pr0grara/EVERFRESH/pamphlet-assets/room.jpg

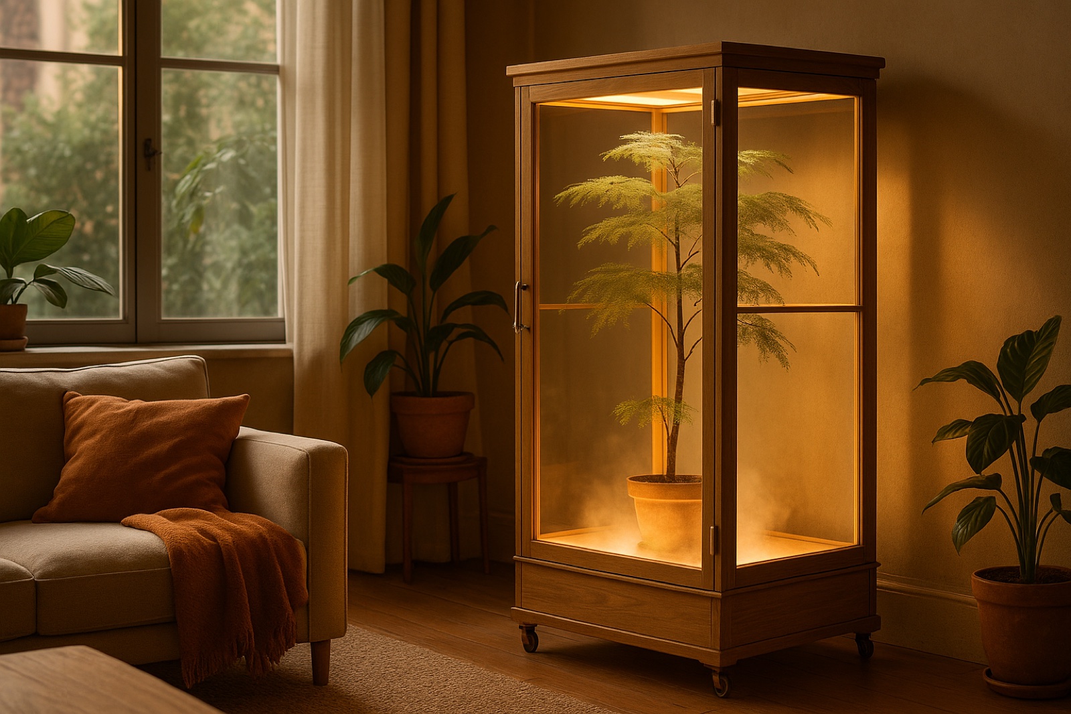
pamphlet-assets/room.jpg
