pr0grara/EVERFRESH/pamphlet-assets/pg1.png

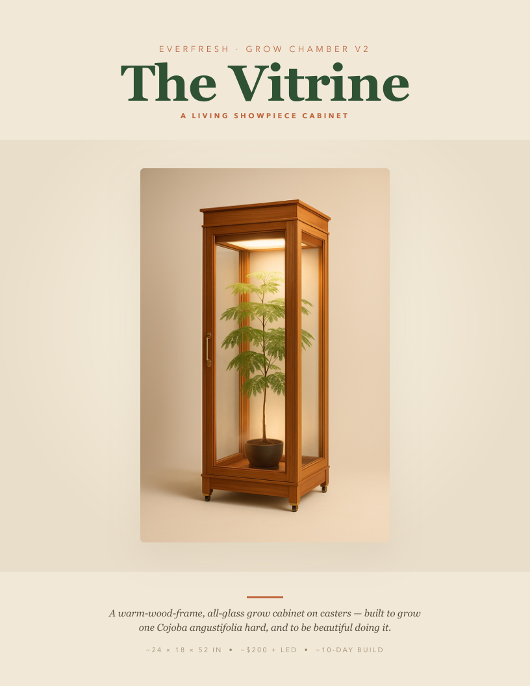
pamphlet-assets/pg1.png
