pr0grara/EVERFRESH/pamphlet-assets/existpdf.png

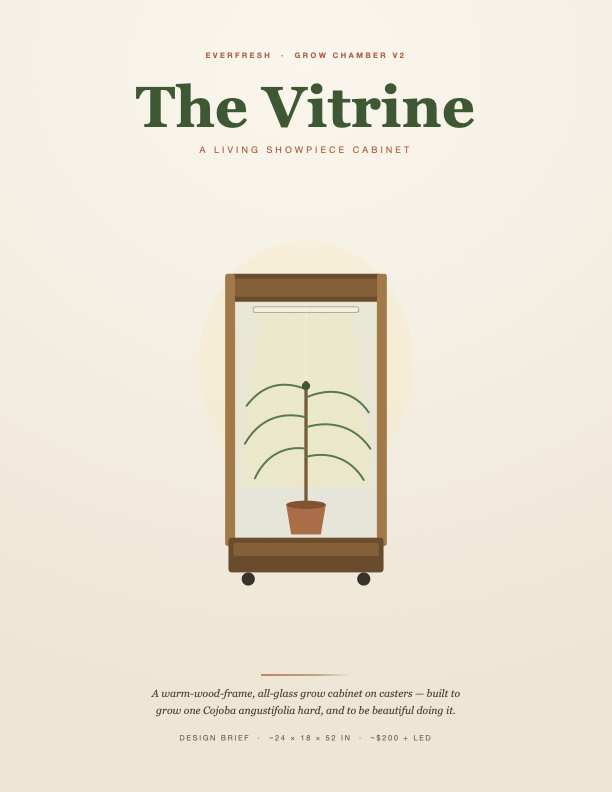
pamphlet-assets/existpdf.png
