pr0grara/EVERFRESH/pamphlet-assets/pg2.png

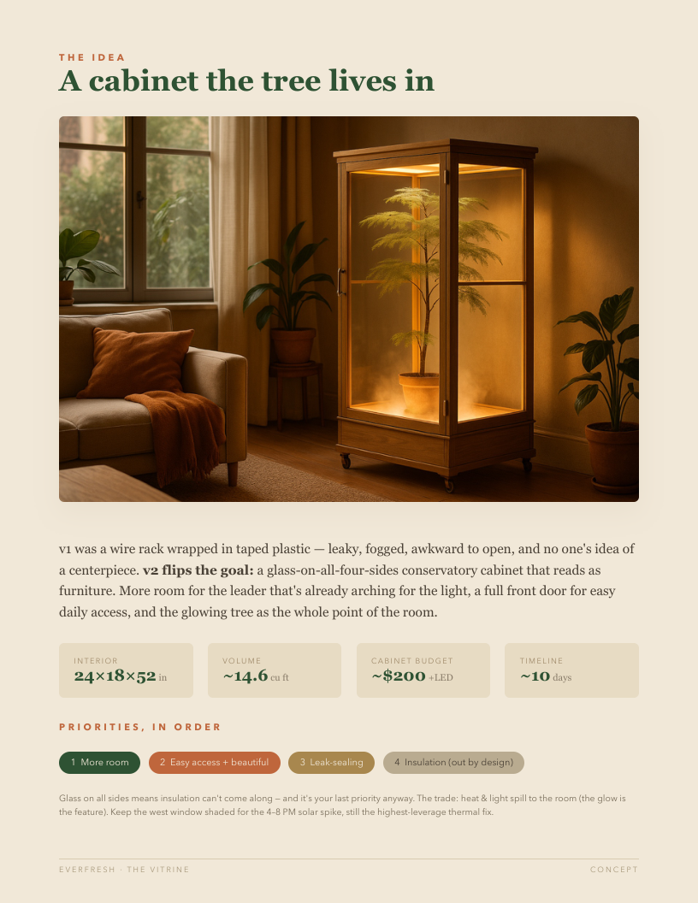
pamphlet-assets/pg2.png
