pr0grara/EVERFRESH/pamphlet-assets/pg3.png

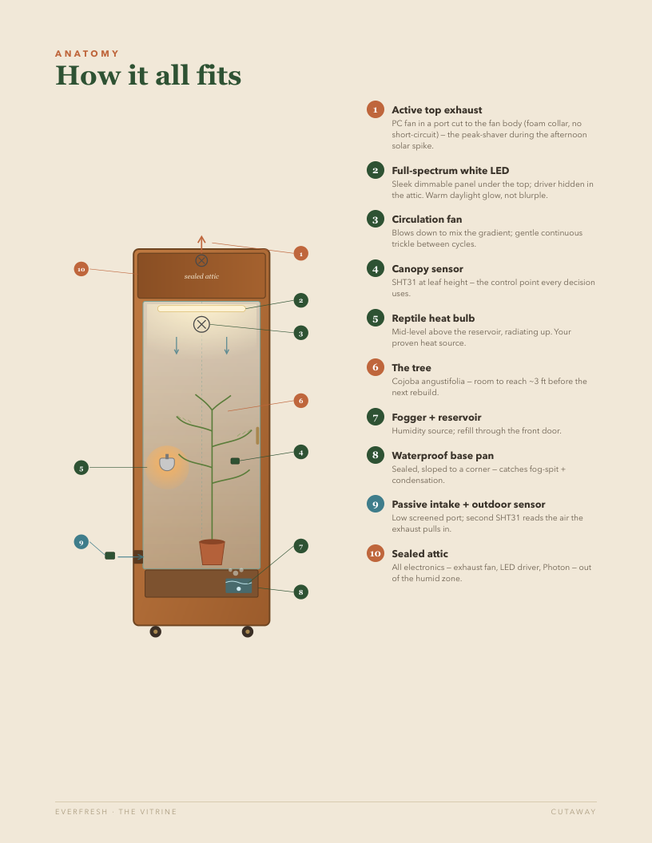
pamphlet-assets/pg3.png
