pr0grara/EVERFRESH/pamphlet-assets/pg4.png

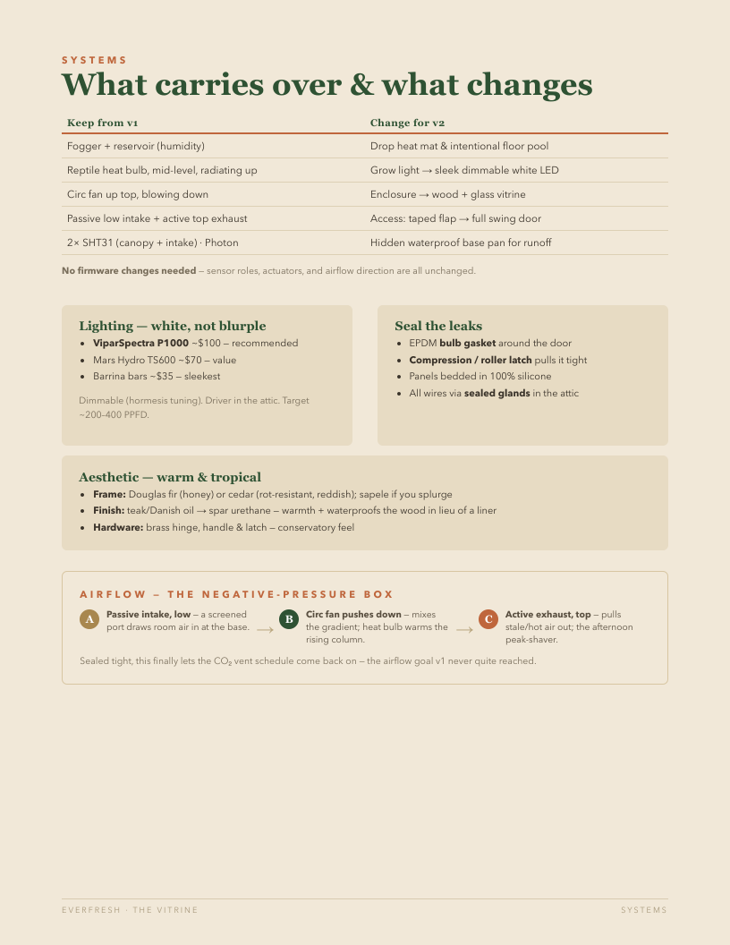
pamphlet-assets/pg4.png
