pr0grara/EVERFRESH/pamphlet-assets/pg5.png

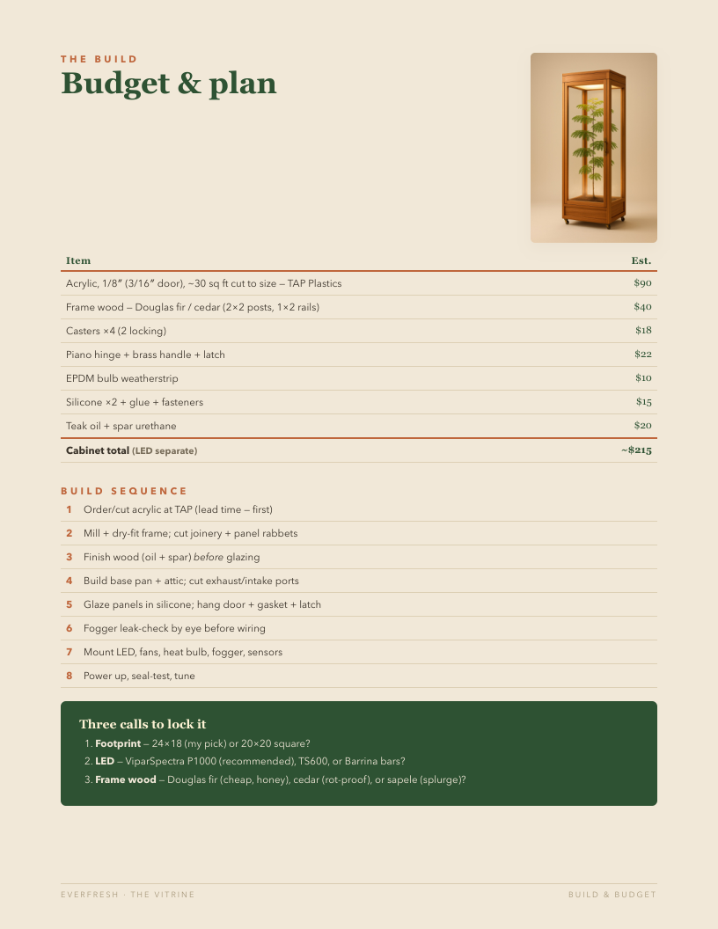
pamphlet-assets/pg5.png
