pr0grara/EVERFRESH/CHANGELOG.md

# EVERFRESH — Changelog

Firmware (`everfresh.ino`) version history, newest first. Each entry: version — date — very brief summary. Versioning is loose semver: `1.MINOR.PATCH`, minor for a new control paradigm/behavior, patch for a tune/fix.

> Renumbered 2026-07-09 so each minor line tracks a control paradigm: `1.1.x` = the VPD-control era, `1.2.x` = the ceramic-heater era. Git commit subjects predating this use the older flat `1.0.x` numbers.

## v1.2.18 — 2026-10-09
Control survives a Wi-Fi/cloud outage. On 10/8 the modem died and the Photon was dark 26.6h. Without `SYSTEM_THREAD(ENABLED)` the app shared the system thread: losing the cloud blocked `loop()`, the 60s `ApplicationWatchdog` reset the device, and after each reset `setup()` waited for the cloud, so every actuator pin floated off for the whole outage (reconnected at 165s uptime, canopy at 59% RH).

- **`SYSTEM_THREAD(ENABLED)`:** setup and the control loop run from boot regardless of Wi-Fi. Before the clock syncs, the existing afternoon-phase fallback applies.
- **`cloudPub()` wrapper** replaces every `Particle.publish`: skips when `!Particle.connected()` so an offline publish can't stall the app thread.
- **Edge alerts retry:** `publishAlerts()` latches a circ-stall / overheat / no-sensor / cleared edge only after the publish succeeds, so an alert raised offline lands when the cloud returns.
- **Off-device companion:** the arabuilds scheduler job "everfresh watchdog" (every 5 min) texts when telemetry goes stale for 20 min, and again when it resumes.

## v1.2.17 — 2026-09-13
Persistent-alert bidaily nag. The edge-triggered alerts in `publishAlerts()` (circ-stall / overheat / no-sensor) fired exactly once on transition, so a fault that didn't self-heal went silent after its first text. Now, matching the v1.2.16 reservoir-dry cadence, `publishAlerts()` re-publishes the still-active alert every `ALERT_REALERT_MS` (12h) while the same condition holds. Requested for circ-stall specifically; generalized to all three since none self-heal and re-nagging a sustained overheat/no-sensor is strictly safer. `"cleared"` still fires once on recovery (no nag). New static `lastAlertPub` timer; reset on every edge so a changed alert re-arms the clock.

## v1.2.16 — 2026-09-13
Reservoir dry-out watchdog + bidaily SMS nag. On 9/12 the fogger reservoir ran dry ~8:47PM; the sheet log showed the signature cleanly — fog pinned 100% ON continuously while canopy RH decoupled and slid 75→57%, then sat at ~55-58% for ~14h with fog at full duty (transducer firing into empty water, atomizing nothing). No alert fired at the time; this adds one.

- **New `publishReservoirAlert()` detector** → publishes `everfresh/alert` = `"reservoir-dry"` when fog is commanded ON continuously for `RES_DRY_MS` (20 min) while canopy RH stays below `RES_DRY_RH` (= `RH_FOG_ON`, 65%). A watered chamber recovers RH within minutes and cycles fog off, so a 20-min flat-out run with no RH response is the dry tell. Clears (`"reservoir-refilled"`) when RH recovers above `RES_OK_RH` (72%) — sits cleanly between the ~55-58% dry floor and the 74-80% normal band so it won't false-clear or nag forever.
- **Bidaily nag:** unlike the edge-triggered alerts, this re-publishes `reservoir-dry` every `RES_REALERT_MS` (12h) while still dry — a refill reminder, since a dry reservoir doesn't self-heal. Deliberately independent of `publishAlerts()`'s single-slot priority system so it can coexist with a simultaneous circ-stall/overheat and keep its own cadence. No-sensor holds the latch (can't judge RH response blind; the no-sensor alert covers that).
- **Off-device:** reuses the v1.2.14 path — Particle webhook → arabuilds `/api/everfresh-alert` → Twilio SMS. Added `reservoir-dry` / `reservoir-refilled` message bodies there.

## v1.2.15 — 2026-09-08
Baseline circ-mix bump. Raised `CIRC_MIX_DUTY` 1%→10% for stronger continuous chamber mixing between fog cycles. Note this floor also drives the mode-3 night dry-excursion pin (circ held at `CIRC_MIX_DUTY` when `excDrying`), so night idle mixing rises to 10% too; `CIRC_NIGHT_MIN` (1) and `HEAT_CIRC_MIN` (1) are separate constants and unchanged. Watch the floor pool for over-drying at the higher baseline.

## v1.2.14 — 2026-08-20
Circ-fan mixing-failure watchdog + SMS alert. The circ fan died 8/20 (inertial bearing lock, freed by hand). Post-mortem on the sheet log showed it had been dying for ~2 weeks — clean ΔT baseline (canopy−ambient ~4-5°F) held until ~8/05, then intermittent stalls spiking ΔT to 24-31°F, lengthening each time (minutes → 40 → 89 → locked). The tell is ΔT, not fog/vent runtime: a real solar spike keeps ΔT low (canopy+ambient rise together), but a stalled fan lets the canopy pocket bake, and stalls hit at all hours incl. dark ones (mechanical, not solar).

- **New `circMixingStalled()` detector** → publishes `everfresh/alert` = `"circ-stall"` when `(canopy − ambient) ≥ CIRC_STALL_ON_DELTA_F` (12°F) holds for `CIRC_STALL_MS` (10 min); clears below `CIRC_STALL_OFF_DELTA_F` (9°F). Hysteretic + time-latched so solar-edge transients can't trip it. Needs both sensors (ambient down → can't judge mixing; no-sensor alert covers canopy loss).
- Folded into `publishAlerts()` priority after no-sensor/overheat (edge-triggered — only publishes on transition).
- **Off-device:** a Particle webhook forwards `everfresh/alert` → arabuilds `/api/everfresh-alert` → Twilio SMS to Ara's cell (from the arabuilds line +14159032724) on any real alert, "cleared" on recovery. Would have paged ~8/07, two weeks before failure.

## v1.2.13 — 2026-08-04
Recovery-week VPD softening. Proactive (not a stress signal): a fresh coppery terminal flush landed the same week as a transplant into a larger pot (2 trip / 1 orchid / 1 potting). Tender new tissue + disturbed roots = lower water supply against higher demand, so ease evaporative pull for ~1 week while the flush hardens and roots re-knit.

- **Ceilings down ~0.15 uniformly** (floors 0.55/0.70/0.85 untouched, so no extra daytime venting; fog just comes on sooner): night/morning `_HI` 1.05→0.90, afternoon 1.15→1.00, evening `_HI` 1.15→1.00, spike `VPD_EVE_CAP` 1.40→1.25.
- Ladder still non-decreasing (night 0.90 = morning 0.90 < afternoon 1.00 = eve HI 1.00 < cap 1.25).
- **Temporary** — re-raise toward the 7/26 ladder once the copper greens up and roots establish.

## v1.2.12 — 2026-07-28
Night vent noise cap. Full-duty venting (cooling pulse / RH relief / dry swing / scheduled exchange) was a 100% blast — too loud at night.

- **Night only:** those reasons now soft-start at `NIGHT_VENT_START_PCT` 10% and ramp to a `NIGHT_VENT_MAX_PCT` 50% ceiling over `NIGHT_VENT_RAMP_MS` (5 min), so brief blips stay ~quiet and only a sustained need climbs to the cap.
- **Untouched:** near-silent moisture-export vent (~1%), the `VENT_EMERGENCY_F` runaway backstop (still forces 100%), and all daytime venting.

## v1.2.11 — 2026-07-26
Further gentle de-stress: another small ceiling down-tick after the 7/23 walk-back proved insufficient.

- **Night/Morning** `VPD_NIGHT_HI`/`VPD_MORN_HI` 1.10→1.05.
- **Afternoon** `VPD_AFT_HI` 1.20→1.15.
- **Evening** `VPD_EVE_HI` 1.20→1.15 and spike cap `VPD_EVE_CAP` 1.45→1.40.
- Floors still untouched (0.55/0.70/0.85) — wet side unchanged; this only makes fog trigger sooner. Ladder still non-decreasing (night 1.05 = morning 1.05 < afternoon 1.15 = evening HI 1.15 < cap 1.40).
- **Trigger:** discoloration now appearing on some leaf **tips** (dry-air tip burn) — the 7/23 half-step wasn't enough to keep the ceramic heater's drying off the canopy. Same monitor-and-adjust discipline; re-read the tips before moving again.

## v1.2.10 — 2026-07-23
Gentle de-stress: partial walk-back of the 7/15b ladder raise after drying pinnae reappeared.

- **Morning** `VPD_MORN_HI` 1.20→1.10 (band 0.55–1.10).
- **Afternoon** `VPD_AFT_HI` 1.30→1.20 (band 0.70–1.20).
- **Evening** `VPD_EVE_HI` 1.30→1.20 and spike cap `VPD_EVE_CAP` 1.50→1.45.
- Floors untouched (0.55/0.70/0.85) — wet side and daytime venting unchanged; this only makes fog trigger sooner. Ladder still non-decreasing (night 1.10 = morning 1.10 < afternoon 1.20 < evening cap 1.45) and morning is back under the old afternoon.
- **Trigger:** ~10 drying pinnae on the leaf nearest the ceramic element + ~5 scattered plant-wide — the same signature as the 7/09 episode that the 7/15a/b raises walked back. Deliberately ~half-way back, not a full revert: this is a monitor-and-adjust step, not an abandonment of the hormetic ladder. See OBSERVATIONS.md 2026-07-23, including a suspected leaf-on-sensor fault that could be biasing canopy RH high (and therefore VPD low) independent of any setpoint.

## v1.2.9 — 2026-07-15
Raise the whole hormetic VPD ladder — strictly ascending fog-triggers through the day.

- **Morning** `VPD_MORN_HI` 0.95→1.20 (band 0.55–1.20).
- **Afternoon** `VPD_AFT_HI` 1.15→1.30 (band 0.70–1.30).
- **Evening** `VPD_EVE_HI` 1.15→1.30 and spike cap `VPD_EVE_CAP` 1.40→1.50 (band 0.85–1.30, solar-window ceiling 1.50).
- Ceiling ladder now night 1.10 < morning 1.20 < afternoon 1.30 < evening 1.50. Floors kept (0.55/0.70/0.85 — no extra daytime venting); bands widen upward. Morning is now deliberately drier than the old afternoon (a real transpiration driver). All triggers < the ~2.0 kPa the plant took fine on 7/14.

## v1.2.8 — 2026-07-15
Widen + raise the daytime VPD bands — walk back the 7/09 de-stress now that the plant recovered and shrugged off ~2.0 kPa on the 7/14 spike.

- **Morning** `VPD_MORN_HI` 0.80→0.95 (band 0.55–0.95; width 0.25→0.40).
- **Afternoon** `VPD_AFT_HI` 0.95→1.15 (band 0.70–1.15; width 0.25→0.45).
- Floors kept (0.55 / 0.70) — wet-side export unchanged, no extra daytime venting; widened upward only. Higher fog-triggers = more hormetic stress; wider deadbands = deeper "chop" (fewer, deeper fog cycles). Ladder preserved: morning 0.95 < afternoon 1.15 < evening cap 1.40. Evening/spike band untouched.

## v1.2.7 — 2026-07-15
Correct the v1.2.6 night behavior after seeing one night run: fog is a LAST RESORT, not disabled; circ trickles, doesn't blow.

- **Fog re-enabled at night as a backstop.** Removed the `PH_NIGHT` fog-kill — fog follows the normal band again, so at night it fires only if canopy VPD exceeds the widened `VPD_NIGHT_HI` (1.10). The floor pool holds RH day-to-day; fog steps in only when a night goes genuinely dry. (Never wanted fog *off* — wanted it last.)
- **Night circ pinned at 1%, not 20%.** `CIRC_NIGHT_MIN` 20→1: a constant gentle trickle (blade turns, little airflow) — never fully off for anti-stagnation, but low enough it doesn't re-wet the pool or act as a humidity lever. Dropped the wet-pulse (`CIRC_NIGHT_WET_PULSE_*`): moot at 1% (nothing to back off from) and it would have cut air movement exactly when RH is highest. The export vent still handles the wet side.

## v1.2.6 — 2026-07-14
Night retune for the risen temp regime (nights climbed ~10°F, now ~80°F/~82% RH — the 7/09 VPD bands were set for cool nights). Circ becomes the night humidity lever; the fogger goes dark overnight.

- **Wider night VPD deadband.** `VPD_NIGHT_HI` 0.70→1.10 (floor `VPD_NIGHT_LO` stays 0.55). Plant is asleep (stomata closed, leaflets folded) so a loose VPD costs nothing.
- **Fog off at night.** In mode 3, `curPhase == PH_NIGHT` forces `autoFog = false` — we rely on circ + the floor pool for RH, not the fogger. Placed before the cooling override so a freak hot night can still re-enable fog for cooling.
- **Circ is the night RH lever (was hard-zero).** At night circ holds continuous `CIRC_NIGHT_MIN`=20% over the floor pool to evaporate water / keep RH up + air moving (anti-stagnation; stagnant warm saturated air is the new fungal risk the old zero ignored). It backs off ONLY if it drives canopy VPD under the wet floor (`VPD_NIGHT_LO`) — and even then it PULSES (`CIRC_NIGHT_WET_PULSE_ON/OFF`, 1 min on / 4 min off) rather than hard-off, so there's always some stir; the export vent does the real drying. Floor only raises a too-low idle; fog/vent-feed (100) and RH-assist (35) still win.

## v1.2.5 — 2026-07-14
Cooling-vent overhaul: looser duty cap, higher band, elastic ambient-tracking release.

- **Duty cap loosened.** Continuous-ON allowance 1 min→3 min and the forced break 3 min→1 min (25%→~75% ceiling). The pulse was never a fixed cycle — `tempVentOn` releases the vent the instant canopy hits the release point or the room stops being cooler, so a mid-burst temp drop still cuts it immediately; the ON time only caps a *sustained* excursion. The old 25% throttle protected RH between bursts, but v1.2.4's independent RH-hold fog now backfills humidity continuously, so the vent only needs a brief 1-min break for fog to work a closed chamber efficiently.
- **Band raised.** `COOL_ON_F` 84→90, `COOL_OFF_F` 82→88 — a hot tropical afternoon regularly rides 85–100°F, so stop fighting heat until 90. `VENT_EMERGENCY_F` stays 99; vent left VPD-uninhibited on purpose (low ambient RH means the fogger can re-crash VPD fast).
- **Elastic release.** The 3°F `VENT_AMBIENT_DELTA_F` gap did double duty (engage + release); split into `VENT_AMBIENT_DELTA_F`=3 (engage — a lead worth starting on) and `VENT_AMBIENT_DELTA_OFF`=1 (release — chase until the canopy is within 1°F of ambient). Net vent release = `max(COOL_OFF_F, ambient+1)`, so on a 92°F-ambient bake it vents 96→~93 and quits instead of pinning ON forever against an unreachable 88° (it can't pull below ambient). No-ambient fails closed → cooling hands to fog.

## v1.2.4 — 2026-07-10
Fog no longer starves during solar bakes. In mode 3 the fogger was slaved to the excursion's MOIST swing, whose stall detector quit within ~1 min once a cooling-vent pulse re-dried the air, then forced a 12-min rest — so during the 7/09–10 4–8 PM spikes canopy VPD parked at 3–4 kPa (RH ~32%) while fog rested. Added an independent, continuous RH/VPD-hold fog term (center-restoring, evening-cap aware) that bypasses the excursion rest/stall/re-arm entirely: vent owns temperature, fog holds RH, both run together. Purely additive — vent-first cooling, fog-for-cooling (`!ventCools()`), and the 95% RH ceiling are unchanged.

## v1.2.3 — 2026-07-09
Expose firmware version remotely: the `version` cloud variable (`particle get <device> version`) AND a `fw` field in the telemetry JSON → a `fw` column in the Sheet (requires the Apps Script redeploy). Closes the "was it actually flashed?" blind spot and stamps every logged row with the build that produced it.

## v1.2.2 — 2026-07-09
Vent-first cooling. Vent is now the preferred cooler whenever it actually cools (`ventCools()`: room ≥3°F cooler than canopy), engaging from 84°F up; fog is forced for cooling ONLY when venting can't (`!ventCools()`). Fog keeps its RH/VPD job. No-ambient fallback flipped to fog-cooling (was heat-importing venting).

## v1.2.1 — 2026-07-09
VPD de-stress. Whole VPD ladder pulled down ~0.25–0.35 kPa, evening cap 2.2→1.4 kPa, night-export thresholds lowered (0.55/0.85→0.35/0.55) — pinnae stopped unfurling under the ceramic element.

## v1.2.0 — 2026-07-08
Ceramic-heater era. Circ night-rule fix + heater circ interlock (holds min circ while the ceramic element is energized so heat can't stratify past the canopy sensor), plus prior fan/night work.

## v1.1.3 — 2026-06-23
Mode 3 (excursion): arm dwell + faster stall window.

## v1.1.2 — 2026-06-23
Mode 3: room-floor stall stop + stricter dry-arm gate.

## v1.1.1 — 2026-06-23
Add controlMode 3: wide-hysteresis excursion (hormetic) humidity control.

## v1.1.0 — 2026-06-23
VPD-based control (the regime change) — first VPD-driven control paradigm.

## v1.0.6 — 2026-06-22
Vent for high-RH relief only after RH is sustained-high, not on an instantaneous spike.

## v1.0.5 — 2026-06-22
Add ambient temp/RH sensor (2nd SHT31 on software I2C); update observations + logger.

## v1.0.4 — 2026-06-20
Update action thresholds; 25% duty cooling vent (1 min ON / 3 min OFF) to preserve RH/VPD.

## v1.0.3 — 2026-06-20
Variable-speed circ fan: ramp circ up as RH approaches the fog trigger (elongate the sawtooth).

## v1.0.2 — 2026-06-20
Circ fan always on; RH on/off triggers bumped to 65/80.

## v1.0.1 — 2026-06-20
Vent off except for cooling and shedding excess humidity.

## v1.0.0 — 2026-06-20
First versioned firmware (heat/fog/circ/vent hysteresis control + Google Sheets logging).
