pr0grara/EVERFRESH/(commit log)

2026-06-20 V1.0.2 circ fan always on and RH on/off triggers bumped up to 65/80
2026-06-20 V1.0.3 add variable speed circulation fan mode to try to elongate sawtooth, as RH approaches fog trigger circ fan increases speed
2026-06-22 v1.0.5, add ambient temp/RH sensor. Update observations and logger
2026-06-23 v1.0.7, add VPD based controls prototype
2026-06-23 v1.0.8 add controlMode 3: wide-hysteresis excursion (hormetic) humidity control
    The PI servo (mode 2) pins VPD to the band midpoint with a tight deadband,
    so it micro-cycles the vent every few seconds and never lets the chamber
    settle. Mode 3 is the hormetic opposite: commit to one big swing, then rest.
    - excursionUpdate(): latched REST/DRY/MOIST state machine on canopy VPD.
    Too wet -> vent hard until VPD overshoots bandHi + EXC_OVERSHOOT_KPA, then
    rest EXC_REST_MS. Too dry -> fog hard until VPD overshoots bandLo - overshoot.
    Same regime interlock + below-room stop as mode 2 pick the feasible lever;
    EXC_MAX_DRIVE_MS safety ends a swing that can't reach overshoot. Heat untouched.
    - M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
    [everfresh.ino]
2026-06-23 v1.0.9 mode 3: room-floor stall stop + stricter dry-arm gate
    First 10 min of v1.0.8 in the field exposed the futile-dry-excursion edge
    case: a cold morning with the room ≈ as moist as the tent (dpGap ~1.7°F,
    ambient VPD ≈ canopy) armed a dry swing that ran vent 100% with zero VPD
    gain — it would have churned to the full 20-min max-drive, fighting the heater.
    - excStalled()/excResetStall(): room-floor stop. While driving, anchor VPD and
    re-anchor on EXC_STALL_MIN_KPA of progress toward target; if no progress for
    EXC_STALL_WINDOW_MS (6 min) the lever can't move VPD (vented down to the
    incoming-air floor / fog can't keep up) -> end the swing, flag BELOW-ROOM.
    Applied to both DRY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
    [everfresh.ino]
2026-06-23 v1.0.10 mode 3: arm dwell + faster stall window
    Field follow-up to v1.0.9. 30s after the v1.0.9 flash the vent kicked on:
    a 1-sample RH spike to ~67% (VPD dipped to the arm floor, dpGap jumped to
    2.8 -> WET) tripped the dry-arm gate on a single instantaneous reading. The
    gap gate worked (2.8 >= 2.5), but there was no duration guard.
    - EXC_ARM_DWELL_MS (2 min): the trigger must HOLD before committing to a
    swing. EX_REST now runs a dwell clock that a transient resets, so a boot/RH
    blip can't launch a vent. Same "sustained, not instantaneous" guard as the
    RH-relief vent (v1.0.6) and the mode-1 dry-vent dwell. Applies both
    directions; reset on arm and on setControlMode.
    - EXC_STALL_WIND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
    [everfresh.ino]
2026-07-08 v1.1.0: circ night-rule fix + heater interlock (and prior fan/night work)
    Tonight's fixes:
    - Fix: the mode-3 night circ-off rule ignored manual overrides, silently
    stomping any setCirc 1-99 to 0 at night. Add a !circManual guard so manual
    holds survive. This is why setCirc("1,5") appeared to do nothing on hardware
    — nothing was broken; the rule zeroed it every control cycle.
    - Add heater circ interlock (HEAT_CIRC_MIN=1): force circ on whenever the
    heater relay is energized, so a radiant element never runs in dead-still air
    and the canopy overtemp sensor (TEMP_SAFETY_F) stays honest. Keyed on the D2
    relay, so it covers the 40W ceramic once it moves onto D2.
    Prior uncommitted fi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
    [everfresh.ino]
2026-07-08 tooling: dew-point/dpGap charting + offline vapor-load observer scripts
    - sheet_snapshots.py: parse ambient sensor + dew points from the log and chart
    canopy/ambient dew points and dpGap (the floor-water evaporation tachometer)
    alongside temp/RH/VPD.
    - scratch_fog.py: offline vapor-load observer experiment — reconstruct hidden
    pool charge from fog runtime minus dpGap-driven evaporation. Decides nothing
    in the controller; validation step before any feedforward firmware change.
    - scratch_vpd.py: quick VPD pull/plot helper against the sheet.
2026-07-10 v1.2.1: VPD de-stress + fog no longer regime-gated
    Whole VPD ladder pulled down ~0.25-0.35 kPa, evening cap 2.2->1.4 kPa,
    night-export thresholds lowered 0.55/0.85 -> 0.35/0.55 -- pinnae stopped
    unfurling under the ceramic element. Also drops the WET-regime interlock
    on fog (vpdPIUpdate/excursionUpdate): fog is a source, not a room-air
    exchange, so dpGap/regime governs VENT only.
    [everfresh.ino]
2026-07-10 v1.2.2: vent-first cooling + add CHANGELOG.md
    Vent is now the preferred cooler whenever it actually cools (ventCools():
    room >= 3F cooler than canopy), engaging from 84F up; fog is forced for
    cooling ONLY when venting can't (!ventCools()). Fog keeps its RH/VPD job.
    ventCools() no-ambient fallback flipped true->false so a sensor failure
    hands cooling to fog, not heat-importing venting (99F backstop still wins).
    Adds CHANGELOG.md (backfilled v1.0.0-> with the 7/09 era renumbering) and a
    Version line in the firmware header.
    [everfresh.ino]
2026-07-10 v1.2.3: expose firmware version as a cloud variable
    Adds cloudVersion ("v1.2.3") + Particle.variable("version", ...) so the
    running build is readable remotely (particle get <device> version).
    Closes the flash-verification blind spot that let a stale build run
    undetected. Mirrors the existing cloudMode/cloudStatus char-array pattern.
2026-07-10 sheets-logger: add fw to testWrite() row for the new column
    testWrite() still wrote the pre-fw 27-value row; append the fw test value
    so the manual bench-write stays aligned with HEADERS. Docs/test-helper
    only — no runtime effect.
2026-07-11 v1.2.4: independent RH-hold fog in mode 3 (unstarve fog during solar bakes)
    In excursion mode the fogger was slaved to the MOIST swing, whose stall
    detector quit within ~1 min once a cooling-vent pulse re-dried the air, then
    forced a 12-min rest. During the 7/09-10 4-8 PM spikes canopy VPD parked at
    3-4 kPa (RH ~32%) while fog rested. Add a continuous RH/VPD-hold fog term
    (reuses vpdWantFog: center-restoring, evening-cap aware) that bypasses the
    excursion rest/stall/re-arm entirely, so vent owns temperature and fog holds
    RH simultaneously. Purely additive: vent-first cooling, fog-for-cooling
    (!ventCools), and the 95% RH ceiling are unchanged.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
    [everfresh.ino]
2026-07-14 v1.2.5: cooling-vent overhaul — looser duty cap, higher band, elastic ambient release
    - duty cap 25%->~75% (ON 1->3min, forced break 3->1min)
    - band raised COOL_ON 84->90 / COOL_OFF 82->88 (emergency stays 99)
    - elastic vent release max(88, ambient+1) via split engage/release
    ambient deltas (3 deg engage / 1 deg release); no-ambient fails to fog
    [everfresh.ino]
2026-07-14 v1.2.5: bump cloudVersion string to v1.2.5 (was still v1.2.4)
    The reported "version" cloud var / telemetry fw field is driven by
    cloudVersion, not the header comment — it was missed in ba2c348.
    [everfresh.ino]
2026-07-15 v1.2.7: correct v1.2.6 night behavior — fog last-resort, circ trickle
    - fog re-enabled at night (remove PH_NIGHT kill): follows the band, so
    fires only as a last resort when night VPD exceeds VPD_NIGHT_HI (1.10)
    - night circ pinned CIRC_NIGHT_MIN 20->1 (constant gentle trickle, never
    fully off for anti-stagnation, not a humidity lever); dropped the now-
    moot wet-pulse. RH left to floor pool + last-resort fog; export vent
    still handles the wet side.
    [everfresh.ino]
2026-07-15 v1.2.9: raise the hormetic VPD ladder (strictly ascending)
    - morning VPD_MORN_HI 0.95->1.20 (band 0.55-1.20)
    - afternoon VPD_AFT_HI 1.15->1.30 (band 0.70-1.30)
    - evening VPD_EVE_HI 1.15->1.30, cap VPD_EVE_CAP 1.40->1.50
    - ceiling ladder: night 1.10 < morning 1.20 < afternoon 1.30 < evening 1.50
    - floors kept (no extra daytime venting); all triggers < 2.0 kPa (proven
    tolerance on the 7/14 spike). Morning now drier than the old afternoon.
    [everfresh.ino]
2026-07-23 v1.2.10: gentle VPD down-tick after drying pinnae reappeared
    Partial walk-back of the 7/15b ladder raise (~half-way, not a full revert):
    morning HI 1.20->1.10, afternoon 1.30->1.20, evening 1.30->1.20, spike cap
    1.50->1.45. Floors untouched, so this only makes fog trigger sooner.
    Trigger: ~10 drying pinnae on the leaf nearest the ceramic element plus ~5
    scattered plant-wide -- same signature as the 7/09 episode. Observations
    logged, including a suspected leaf-on-sensor fault that would bias canopy RH
    high and VPD low independent of any setpoint.
    [everfresh.ino]
2026-07-24 Ignore scratchpad_log.csv — 23M of raw console telemetry, not source
    Same category as snapshots/ and tools/*.log: pulled off the Particle console
    to chart against, regenerable, and far too large to carry in the repo.
2026-07-28 v1.2.11: down-tick VPD ceilings after dry-air tip burn
    Leaf-tip discoloration (dry-air burn) showed the 7/23 walk-back wasn't
    enough — the fog triggers were still letting the ceramic heater bite.
    Uniform step on the ceilings only (floors untouched): morning/night
    1.10→1.05, afternoon →1.15, evening HI 1.20→1.15, spike cap 1.45→1.40.
    Ladder stays non-decreasing. Monitor-and-adjust; re-read the tips before
    moving again. Log in CHANGELOG/OBSERVATIONS. Gitignore .wrangler cache.
    [everfresh.ino]
2026-07-31 firmware v1.2.12 — night full-duty vent noise cap
    Full-duty venting (cooling pulse / RH relief / dry swing / scheduled
    exchange) ran a 100% blast — too loud at night next to a sleeping house.
    During PH_NIGHT those reasons now soft-start at NIGHT_VENT_START_PCT (10%)
    and ramp linearly to a NIGHT_VENT_MAX_PCT (50%) ceiling over
    NIGHT_VENT_RAMP_MS (5 min), so brief blips stay quiet and only a sustained
    need climbs to the cap. The near-silent moisture-export vent (~1%), the
    VENT_EMERGENCY_F runaway backstop (still forces 100%), and all daytime
    venting are untouched.
    [everfresh.ino]
2026-07-31 tools: add 48-hour snapshot script
    snapshot48.py pulls the 'log' sheet as public CSV and prints a text summary
    (stats + actuator duty + per-day solar peaks) plus one 48h chart. Standalone;
    reuses the fetch/column conventions of sheet_snapshots.py.
2026-08-04 firmware v1.2.13 — recovery-week VPD softening (fresh flush + transplant)
    Coppery terminal flush + transplant into a larger pot landed the same week.
    Tender new tissue + disturbed roots (reduced water uptake ~1-2wk) → back the
    VPD ceilings off ~0.15 uniformly so fog holds RH up. Floors untouched (no extra
    daytime venting). Ladder stays non-decreasing. Temporary; re-raise once the
    copper greens up and roots establish.
2026-08-16 Add 7-day snapshot tool (snapshot_week.py)
    Pulls the 'log' sheet as public CSV and prints a text summary (stats, actuator
    duty, per-day solar peaks) plus a 48h chart. Standalone; reuses the fetch/column
    conventions of sheet_snapshots.py.
2026-08-20 firmware v1.2.14 — circ-fan mixing-failure watchdog + SMS
    Circ fan died 8/20 (inertial lock). Log post-mortem showed ~2wk creep:
    canopy-ambient ΔT is the tell (solar keeps ΔT low; a stalled fan bakes the
    canopy pocket → ΔT 24-31°F at all hours). New circMixingStalled() publishes
    everfresh/alert=circ-stall when ΔT ≥12°F holds 10min, clears <9°F (hysteretic,
    time-latched). Folded into publishAlerts() after no-sensor/overheat. Off-device:
    Particle webhook → arabuilds /api/everfresh-alert → Twilio SMS to Ara.
    [everfresh.ino]
2026-09-13 firmware v1.2.16 — reservoir dry-out watchdog + bidaily SMS
    publishReservoirAlert(): fog commanded ON continuously ≥20min (RES_DRY_MS)
    while canopy RH stays <65% (RES_DRY_RH) => everfresh/alert=reservoir-dry.
    That fog/RH decouple is the dry-reservoir tell (proven 9/12: fog pinned
    100%, RH slid 75→57% and stuck ~55-58% for ~14h). Independent of
    publishAlerts' single-slot priority so it coexists with circ-stall/overheat
    and keeps its own cadence; re-fires every 12h (RES_REALERT_MS) while dry as
    a refill nag; clears reservoir-refilled at RH≥72% (RES_OK_RH, between the
    dry floor and the 74-80% normal band). arabuilds /api/everfresh-alert gains
    reservoir-dry/refilled SMS bodies.
    Also lan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
2026-09-13 firmware v1.2.17 — bidaily re-nag for persistent alerts
    publishAlerts() edge-triggered alerts (circ-stall / overheat / no-sensor)
    fired once on transition, so a fault that didn't self-heal went silent
    after its first text. Now re-publishes the still-active alert every
    ALERT_REALERT_MS (12h) while the condition holds — matching the v1.2.16
    reservoir-dry cadence. Requested for circ-stall; generalized to all three
    since none self-heal. "cleared" still fires once on recovery. New static
    lastAlertPub timer, reset on each edge.
2026-09-16 Add Chamber v2 "Vitrine" design doc and pamphlet assets
    - Add CHAMBER-V2.md: full "Vitrine" v2 grow-cabinet design spec (all-glass wood-frame, layout, leak-sealing, lighting, budget, cut list, build sequence)
    - Add pamphlet-assets/build.py: script embedding hero/room images and an SVG cutaway into a standalone pamphlet
    - Add rendered pamphlet outputs (pamphlet.html/.pdf, pg1-5.png) and source imagery (hero/room/vitrine renders)
2026-10-10 nightly: v1.2.18: control survives a Wi-Fi/cloud outage
    - SYSTEM_THREAD(ENABLED) so setup/loop run without cloud
    - cloudPub() wrapper skips publishes when offline, avoids stall
    - publishAlerts() latches edge only after publish succeeds, retries offline alerts
    - note off-device watchdog texting on stale telemetry in changelog
2026-10-11 nightly: add CAD brief for pro-build grow chamber
    - add CAD-BUILDER-PROMPT.md with full handoff spec for Rhino builder
    - add cad-brief/ with BUILDER-BRIEF, START-HERE, build.py and zones.svg
    - ignore local photos and rendered output in cad-brief/
